bran28/ECE411-Team11/Homework/PracticumHW4A(Breadboard Pic).jpg

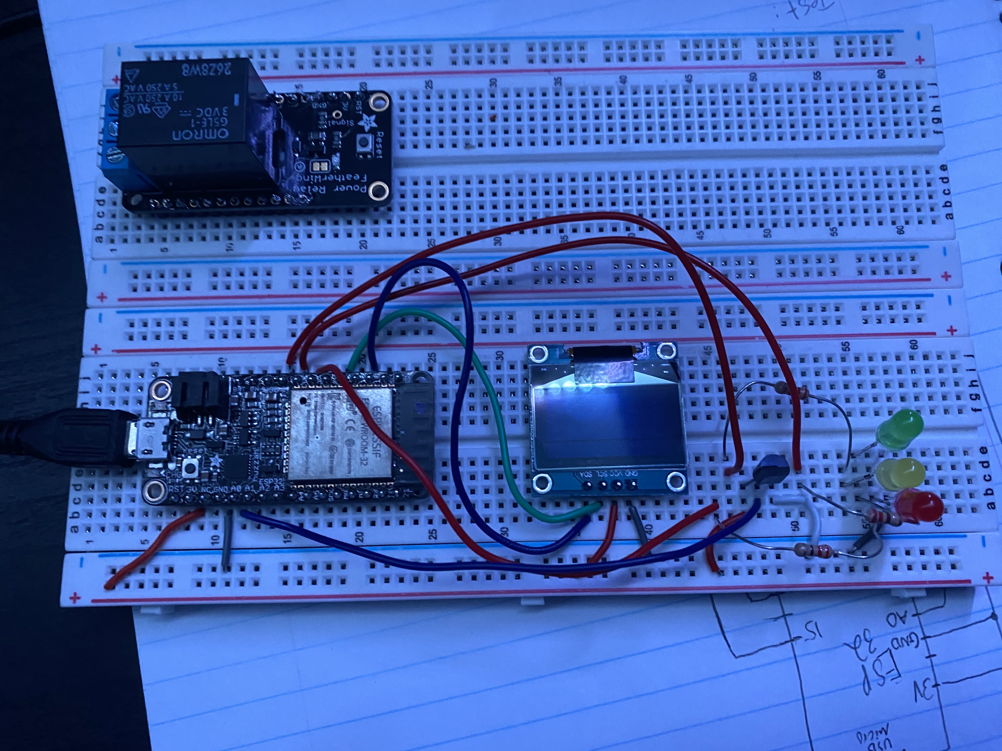
Homework/PracticumHW4A(Breadboard Pic).jpg
