bran28/ECE411-Team11/README.md

# ECE411-Team11
ECE 411 -Team 11 practicum project.
