bran28/ECE411-Team11/Homework/Homework6.pdf

411-Team 11 |1

ECE 411-Team 11

11/26/20

Brandon Garcia

Qingchuan Hou

Yikun Wang

Yudi Bao

Modeling- Auto Cooling Fan

Model 1(Physical View ):

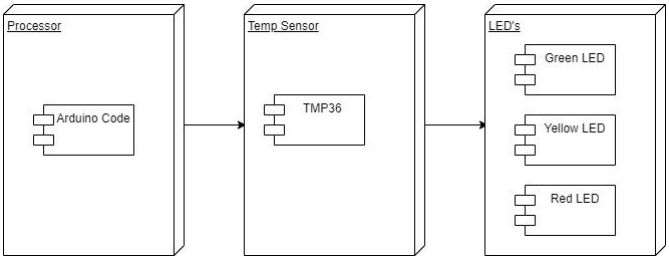
[picture p6: figure]

411-Team 11 |2

Model 2(State-Temperature Read Process):

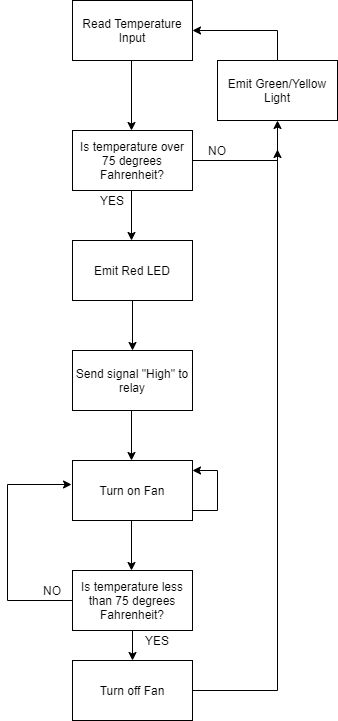
[picture p7: figure]
