bran28/ECE411-Team11/PCB Design/Final Schematic-Layout/FinalSchV1.3.JPG

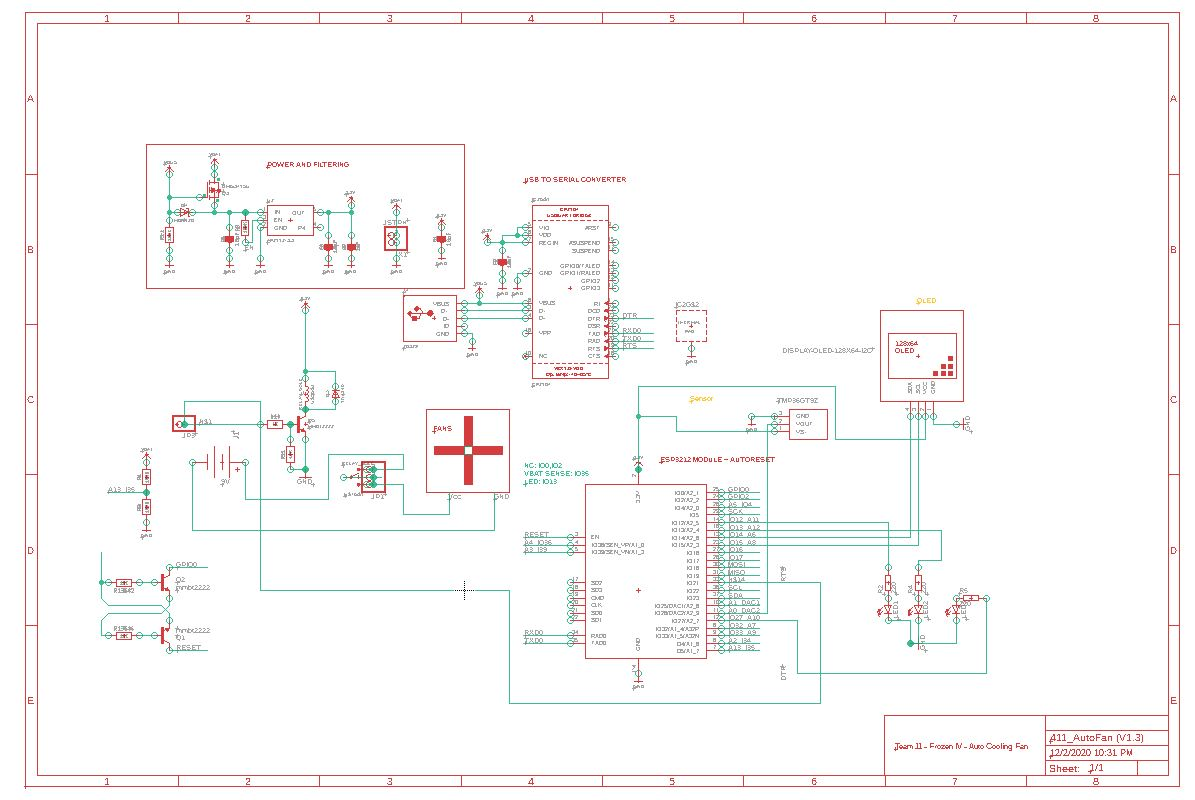
PCB Design/Final Schematic-Layout/FinalSchV1.3.JPG
