bran28/ECE411-Team11/PCB Design/schematic.png

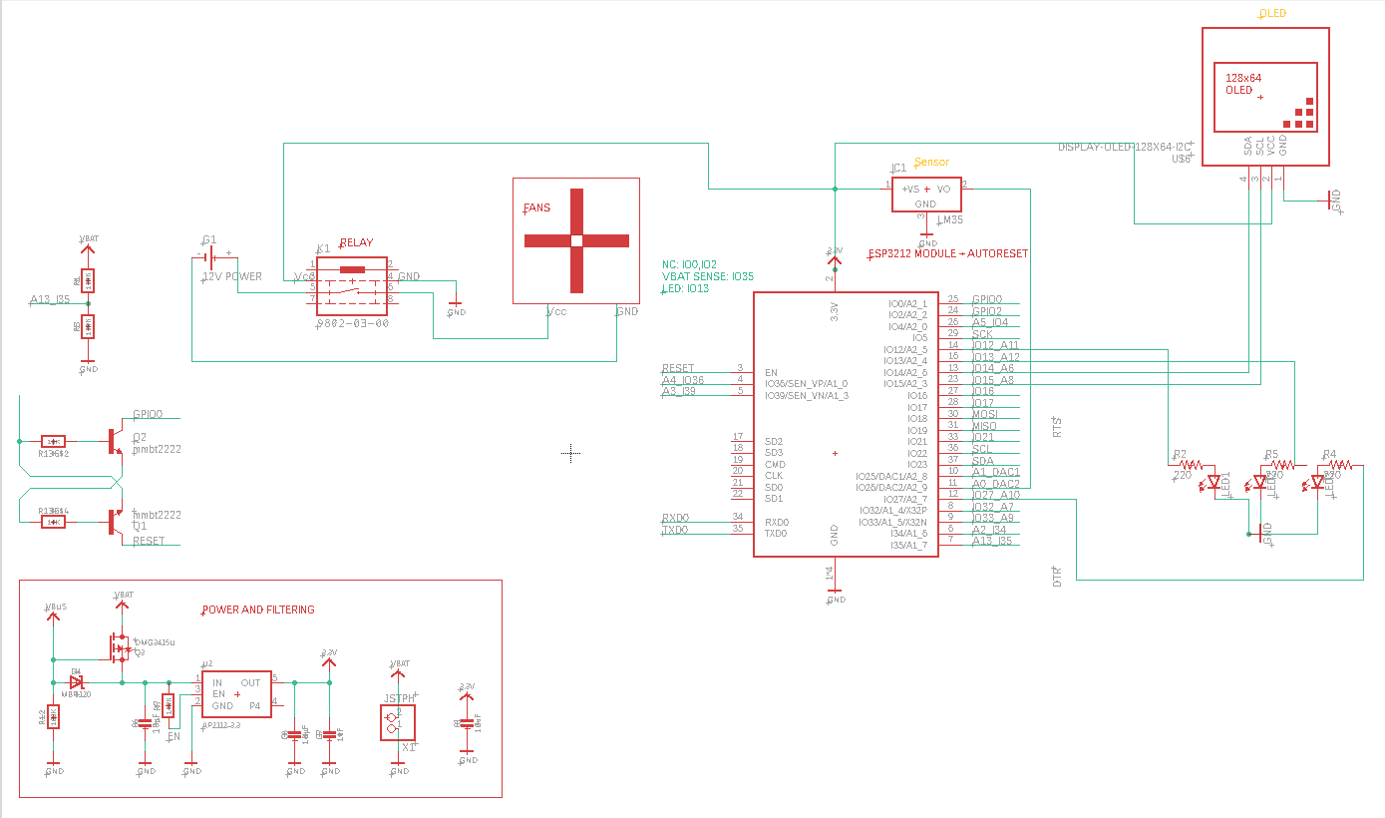
PCB Design/schematic.png
