bran28/ECE411-Team11/411_Team11BOM (version 1.1).xlsb.xlsx

Bill Of Materials for: [TEAM 11] [Frozen IV]
Last modified: [11/18/2020]
PCB version: [1.1] | [1.01]
BOM revision: [1] |  | P/NP | = Place/Not Place (components marked NP are not stuffed on the board)
Cnt | Part References | P/NP | Mfg | Mfg PN | Description | Dist | Dist Part Number | Cost Ea. | Cost Total
 | C11, C17, C22, C23 | P | Yageo | CC0603KRX5R7BB105 | 1µF ±10% 16V Ceramic Capacitor X5R 0603 | Digi-Key | 311-1444-1-ND
2 | C15, C18 | P | Samsung | CL05C200JB51PNC | 20pF ±5% 50V Ceramic Capacitor C0G, NP0 0402 | Digi-Key | 1276-6601-1-ND
1 | C16 | P | Murata | GRM21BD71A226ME44L | 22µF ±20% 10V Ceramic Capacitor X7T 0805 | Digi-Key | 490-9959-1-ND
6 | C3, C13, C14, C19, C20, C21 | P | Samsung | CL05B104KO5NNNC | 0.1µF ±10% 16V Ceramic Capacitor X7R 0402 | Digi-Key | 1276-1001-1-ND
1 | C8 | NP | N/A | N/A | NP | N/A | N/A
1 | C9 | P | Samsung | CL21B106KOQNNNG | 10µF ±10% 16V Ceramic Capacitor X7R 0805 | Digi-Key | 1276-6472-1-ND
3 | CM1, CM2, CM3 | P | Molex | 73300-0020 | SMPM Connector Plug, Male Pin 50Ohm Board Edge | Digi-Key | WM10772-ND
2 | D3, D6 | P | Rohm | SML-E12M8WT86 | Green 572nm LED Indication - Discrete 2.2V 0603 | Digi-Key | 511-1584-1-ND
2 | D5, D7 | P | Inolux | IN-S63AT5A | Amber 605nm LED Indication - Discrete 1.9V 0603 | Digi-Key | 1830-1064-1-ND
1 | J1 | P | Samtec | TFM-110-01-L-D-RA | Connector Header Through Hole, Right Angle 20 position 0.050" | Digikey | SAM10113-ND
3 | J2, J3, J4 | P | TE Connectivity | 1909763-1 | U.FL (UMCC) Connector Jack | Digi-Key | A118077CT-ND
1 | J6 | P | Samtec | TFM-120-01-L-D-RA | Connector Header Through Hole, Right Angle 40 position 0.050" | Digi-Key | SAM10145-ND
1 | J7 | P | Wurth |  | ORESAT-DEBUG-CONNECTOR-SOLAR | N/A | N/A
1 | F1 | NP | Insignia | NS-PCF808 | 80mm Case Cooling Fan - Black | Best-Buy | 5976302 | $6.99 | $6.99
1 | V1 | P | Diodes Incorporated | AP2112K-3.3TRG1 | IC REG LINEAR 3.3V 600MA SOT25 | Digi-Key | AP2112K-3.3TRG1DICT-ND | $0.47 | $0.47
1 | DR1 | P | ON Semiconductor | MBR120ESFT3G | DIODE SCHOTTKY 20V 1A SOD123FL | Digi-Key | MBR120ESFT3GOSCT-ND | $0.36 | $0.36
1 | T2 | P | Diodes Incorporated | DMG3415U-7 | MOSFET P-CHANNEL ENHANCEMENT MODE | Mouser | 621-DMG3415U-7 | $0.43 | $0.43
2 | C2 | P | Yageo | CC1210KFX7R8BB106 | 10µF ±10% 25V Ceramic Capacitor X7R 1210 (3225 Metric) | Digi-Key | 13-CC1210KFX7R8BB106CT-ND | $0.64 | $1.28
2 | C1 | P | Yageo | CC0603KPX7R8BB105 | 1µF ±10% 25V Ceramic Capacitor X7R 0603 (1608 Metric) | Digi-Key | 13-CC0603KPX7R8BB105CT-ND | $0.26 | $0.52
1 | U1 | P | Silicon Labs | CP2104-F03-GM | I/O Controller Interface IC USB to UART Bridge QFN24 | Mouser | 634-CP2104-F03-GM | $1.65 | $1.65
1 | M1 | P | Espressif Systems | ESP32-WROOM-32D (4MB) | Bluetooth, WiFi 802.11b/g/n, Bluetooth v4.2 +EDR, Class 1, 2 and 3 Transceiver Module 2.4GHz ~ 2.5GHz Integrated, Trace Surface Mount | Digi-Key | 1965-ESP32-WROOM-32D(4MB)CT-ND | $3.80 | $3.80
4 | R6 | P | Bourns Inc. | CR0805-JW-104ELF | 100 kOhms ±5% 0.125W, 1/8W Chip Resistor 0805 (2012 Metric) Moisture Resistant Thick Film | Digi-Key | 118-CR0805-JW-104ELFCT-ND | $0.10 | $0.40
3 | D5 | P | Diodes Incorporated | MMBT2222A-7-F | Bipolar Transistors - BJT 40V 300mW | Mouser | 621-MMBT2222A-F | $0.13 | $0.39
1 | D4 | P | Diodes Incorporated | 1N4148WS-13-F | DIODE GEN PURP 75V 150MA SOD323 | Digi-Key | 1N4148WS-13-FDICT-ND | $0.20 | $0.20
1 | R5 | P | Bourns Inc. | CR0805-JW-102ELF | 1 kOhms ±5% 0.125W, 1/8W Chip Resistor 0805 (2012 Metric) Moisture Resistant Thick Film | Digi-Key | CR0805-JW-102ELFCT-ND | $0.10 | $0.10
3 | R4 | P | Bourns Inc. | CR0805-JW-103ELF | RES SMD 10K OHM 5% 1/8W 0805 | Digi-Key | CR0805-JW-103ELFCT-ND | $0.10 | $0.30
1 | RE1 | P | Omron Electronics | G5LE-1 DC3 | General Purpose Relay SPDT (1 Form C) 3VDC Coil Through Hole | Digi-Key | Z3695-ND | $1.49 | $1.49
1 | S1 | P | Uctronics | U602602 | UCTRONICS 0.96 Inch OLED Module 12864 128x64 Yellow Blue SSD1306 Driver I2C Serial Self-Luminous Display Board | NA | NA | $6.99 | $6.99
1 | D3 | P | Romh Semiconductor | SLR-56YC3F | Yellow 587nm LED Indication - Discrete 2.1V Radial | Digi-Key | 511-1265-ND | $0.55 | $0.55
1 | D2 | P | Romh Semiconductor | SLR-56MG3F | Green 572nm LED Indication - Discrete 2.1V Radial | Digi-Key | 511-1262-ND | $0.55 | $0.55
1 | D1 | P | Romh Semiconductor | SLR-56VR3F | Red 630nm LED Indication - Discrete 2V Radial | Digi-Key | 511-1264-ND | $0.58 | $0.58
1 | T1 | P | Analog Devices | TMP36GT9Z | Temperature Sensor Analog, Local -40°C ~ 125°C 10mV/°C TO-92-3 | Digi-Key | TMP36GT9Z-ND | $1.48 | $1.48
3 | R1, R2, R3 | P | Bourns Inc. | CR0805-JW-221ELF | 220 Ohms ±5% 0.125W, 1/8W Chip Resistor 0805 (2012 Metric) Moisture Resistant Thick Film | Digi-Key | CR0805-JW-221ELFCT-ND | $0.10 | $0.30
 |  |  |  |  |  |  |  |  | $28.83
VERSION INFO
Rev | Date | Notes
1.0r1 | 2020-11-19 | Cleaned up parts, rough draft of board
1.0r0 | 2020-11-12 | Initial BOM. Not everything chosen, lots wrong. Mostly just exported from EAGLE.
