bran28/ECE411-Team11/Homework/PracticumHW6(RD)/411_AutoFan_V1.1.brd

## EAGLE design Homework/PracticumHW6(RD)/411_AutoFan_V1.1.brd (2020-12-04)

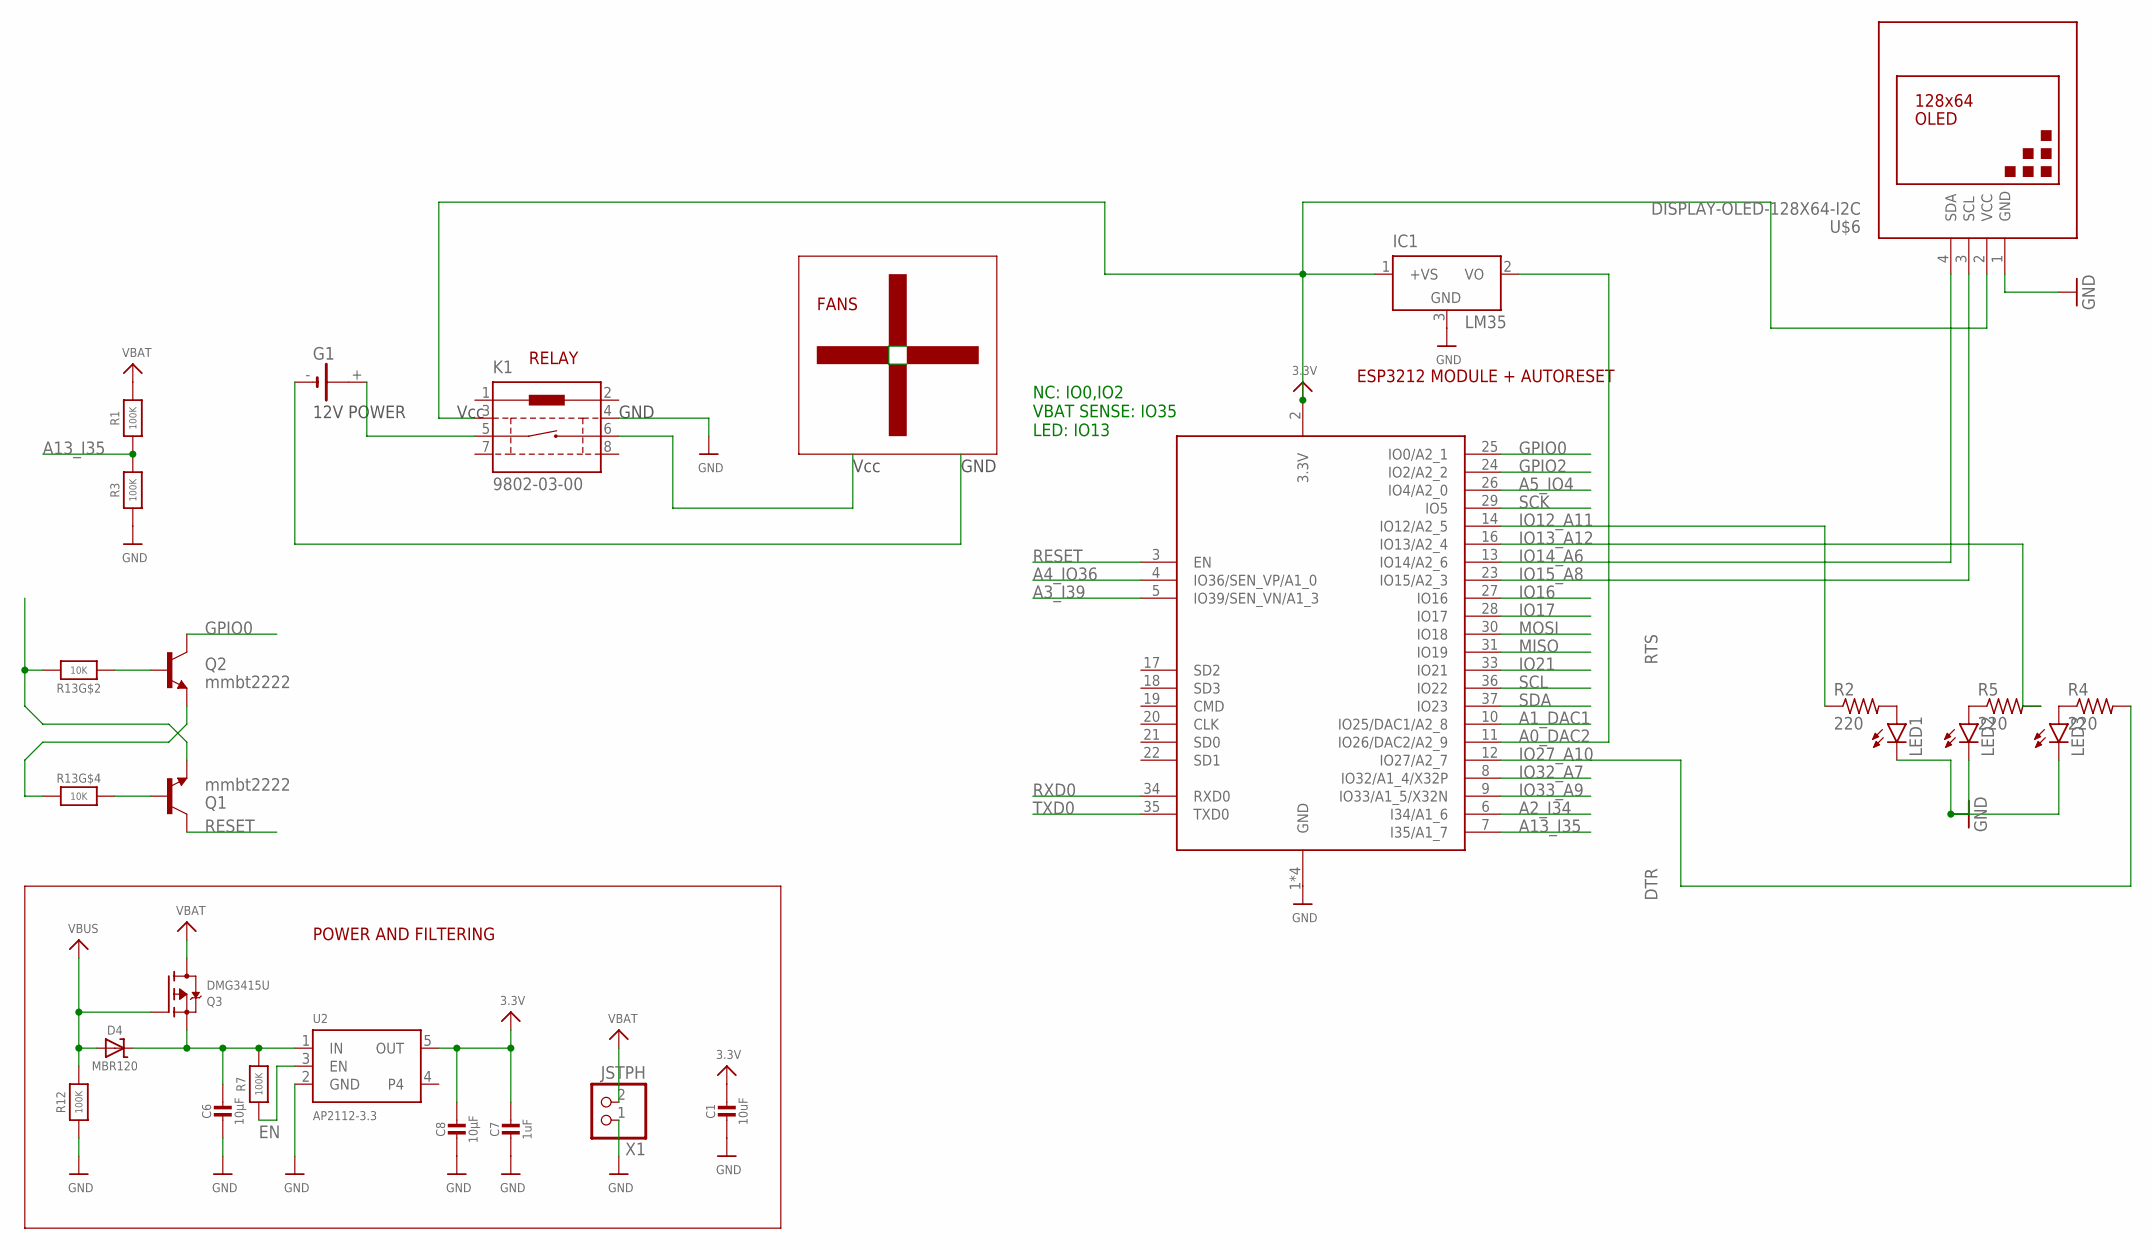
[picture p11: schematic 411_AutoFan_V1.1.sch]

Parts:
C1: 10uF; 0805-NO
C6, C8: 10µF; 0805-NO
C7: 1uF; 0603-NO
D4: MBR120; SOD-123
G1: CR2032V
IC1: LM50; SOT23
K1: 9802-03-00; 9802-00
LED1, LED2, LED3: LED5MM
Q1, Q2: mmbt2222; SOT23-3
Q3: DMG3415U; SOT23-R
R1, R3, R7, R12: 100K; 0603-NO
R2, R4, R5: 220; 0204/7
R13: 10K; RESPACK_4X0603
U2: AP2112-3.3; SOT23-5
U$6: DISPLAY-OLED-128X64-I2C
X1: JSTPH; JSTPH2
X2: ESP32_WROOM32_SKINNY; WROOM32_SKINNY

Connections:
A0_DAC2: IC1.2 (VO), X2.11 (IO26/DAC2/A2_9)
A1_DAC1: X2.10 (IO25/DAC1/A2_8)
A2_I34: X2.6 (I34/A1_6)
A3_I39: X2.5 (IO39/SEN_VN/A1_3)
A4_IO36: X2.4 (IO36/SEN_VP/A1_0)
A5_IO4: X2.26 (IO4/A2_0)
A13_I35: R1.1, R3.2, X2.7 (I35/A1_7)
DTR: Q2.2 (E), R13.4 (1)
EN: R7.1, U2.3 (EN)
GND: C1.2, C6.2, C7.2, C8.2, IC1.3 (GND), K1.4, LED1.K (C), LED2.K (C), LED3.K (C), R3.1, R12.1, U2.2 (GND), U$6.1 (GND), X1.1, X2.1 (GND), X2.15 (GND), X2.38 (GND), X2.P$1 (GND)
GPIO2: X2.24 (IO2/A2_2)
IO12_A11: R2.1, X2.14 (IO12/A2_5)
IO13_A12: R5.2, X2.16 (IO13/A2_4)
IO14_A6: U$6.4 (SDA), X2.13 (IO14/A2_6)
IO15_A8: U$6.3 (SCL), X2.23 (IO15/A2_3)
IO16: X2.27 (IO16)
IO17: X2.28 (IO17)
IO21: X2.33 (IO21)
IO27_A10: R4.2, X2.12 (IO27/A2_7)
IO32_A7: X2.8 (IO32/A1_4/X32P)
IO33_A9: X2.9 (IO33/A1_5/X32N)
MISO: X2.31 (IO19)
MOSI: X2.30 (IO18)
unnamed: LED1.A, R2.2
unnamed: LED3.A, R4.1
unnamed: LED2.A, R5.1
unnamed: C6.1, D4.C, Q3.2 (S), R7.2, U2.1 (IN)
unnamed: G1.+, K1.5
unnamed: Q1.1 (B), R13.5 (2)
unnamed: Q2.1 (B), R13.2 (1)
RESET: Q1.3 (C), X2.3 (EN)
RTS: Q1.2 (E), R13.7 (2)
RXD0: X2.34 (RXD0)
SCK: X2.29 (IO5)
SCL: X2.36 (IO22)
SDA: X2.37 (IO23)
TXD0: X2.35 (TXD0)
VBAT: Q3.3 (D), R1.2, X1.2
VBUS: D4.A, Q3.1 (G), R12.2

Notes on the sheet:
ESP3212 MODULE + AUTORESET
NC: IO0,IO2 VBAT SENSE: IO35 LED: IO13
POWER AND FILTERING
LM35
Vcc
GND
12V POWER
FANS
RELAY

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
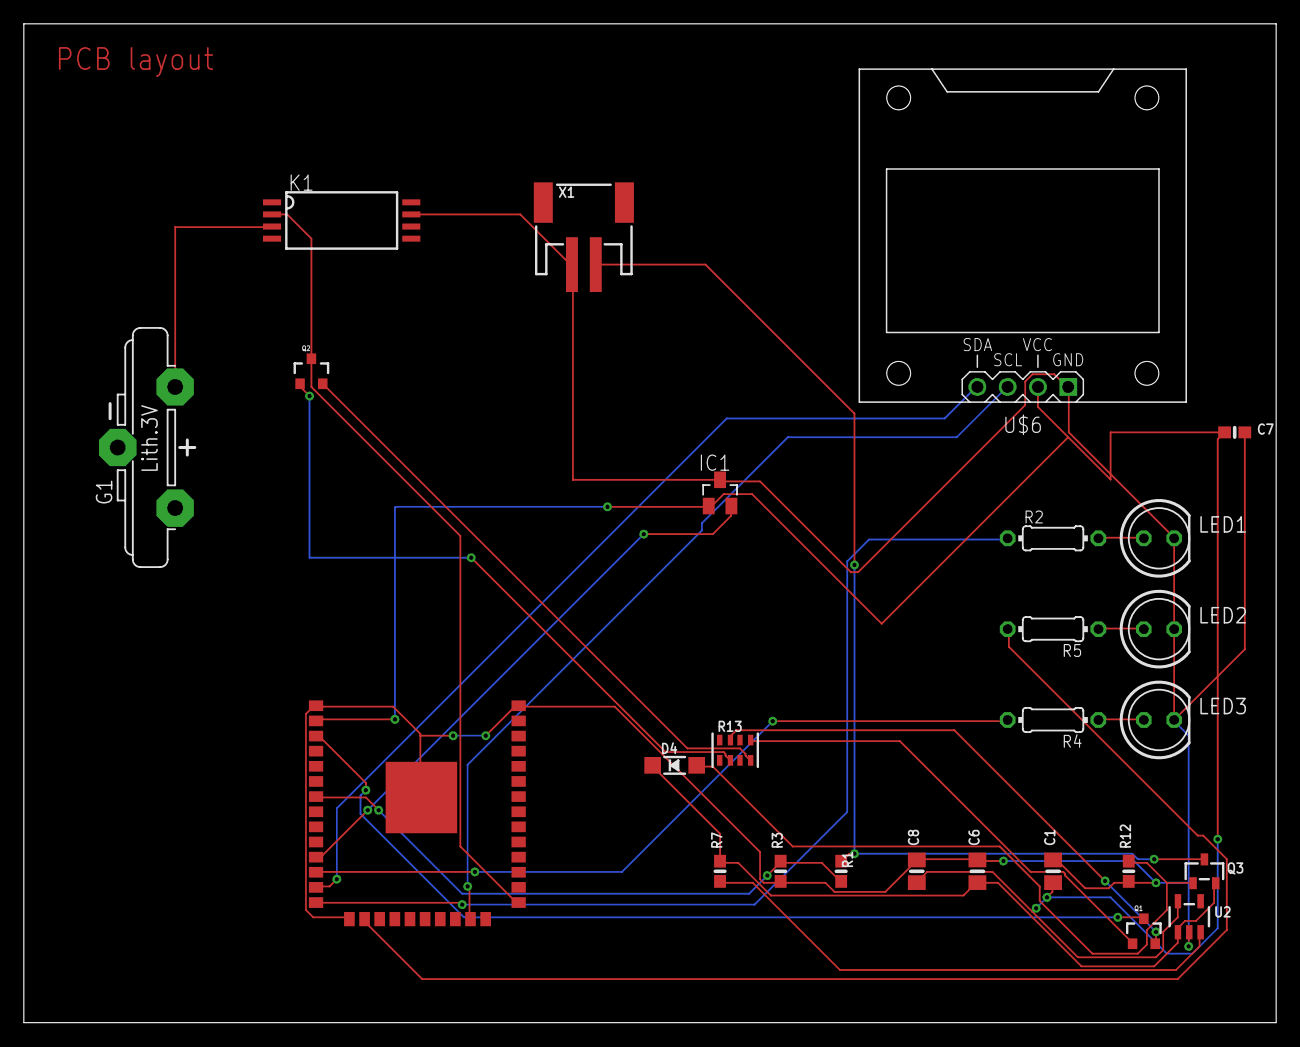
[picture p12: board 411_AutoFan_V1.1.brd from above]

Board: 2 copper layers, 105.1 x 83.8 mm, 26 parts (0 on the bottom side), 23 nets.
