bran28/ECE411-Team11/(commit log)

2020-11-02 Create PCB Design
2020-11-02 Create Breadboard Prototype
2020-11-02 Create PrototypeVideo Link
2020-11-11 Sch update
    [411_AutoFan_New.sch]
2020-11-19 Add files via upload
    Final Schematic Version 1.3
    [411_AutoFan (V1.3).sch]
2020-11-19 Create Final Schematic
2020-12-03 Organzing HW files
    [PracticumHW6A.xlsx]
2020-12-03 Version updated
    [411_AutoFan_V1.1.brd, 411_AutoFan_V1.1.sch, 411_AutoFan_V1.sch]
2020-12-04 Practicum HW's updated
    [PracticumHW4B(SCH).sch, PracticumHW5.brd]
2020-12-04 Homework Files re-organized
    [PracticumHW6A(BOM).xlsx]
2020-12-04 Renamed File
    [411_AutoFan_New.sch]
